juan-felipe-castilla/Digital3/README.md

# Osciloscopio Digital
> **Asignatura:** Electrónica Digital III - Universidad Nacional de Córdoba
> 
> **Integrantes:** 
>  - **Viberti, Benjamín**
>  - **Castilla, Felipe**
>  - **Dalmazzo, Agustín**
>    
> -**Profesor:**
 >- **Blasco Marcos**

---

## 🚀 1. Descripción General del Proyecto
Este proyecto consiste en el diseño y desarrollo de un **Osciloscopio Digital** basado en el microcontrolador **LPC1769** (arquitectura ARM Cortex-M3).

El objetivo principal es la **adquisición de señales analógicas**, su procesamiento  mediante técnicas de software y hardware  y la transmisión a una computadora para su visualización, mediante UART, y tambien posee un generador de funciones interno, para así poder realizar ensayos a diferentes dispositivos.

### 🎯 Alcances del Proyecto 

* **El sistema SÍ es capaz de:**
* 
* Muestrear y procesar señales de frecuencias medias, bajas.
* Una precisión en su medidas válidas para realizar pruebas en casa
* Atenuar señales de entrada, para así ampliar su rango dinamico
* Generar señales de frecuencia fija
* Mostrar tanto niveles de amplitud y tiempo, junto a un botón que muestra la frecuencia de entrada
* 
* **El sistema NO incluye:**
* 
* Muestreo de alta frecuencia
* Una precisión comparable a uno comercial
* Un trigger ajustable

### ⏩ Posibles Etapas Siguientes
Cómo escalar el proyecto:
* Utilizar otro protocolo de comunicación serie, más eficiente
* Utilizar un módulo de adc más exacto, externo
* Agregar una punta compensada
* Poder hacerlo portatil, es decir, que no se requiera una computadora completa para su funcionamiento

---

## 📐 2. Arquitectura del Sistema: Hardware y Software

### 🔌 Hardware & Interconexión
* **Diagrama de Bloques:**Diagrama_Circuito
* **Esquemático del Circuito:** 
  

* **Descripción del Circuito y Consideraciones de Diseño:** En la entrada se encuentra un filtro pasa-bajos de 5kHz que cumple la funcion de filtro anti Aliasing, siguiente a este se puede encontrar un DIP Switch que nos permitira seleccionar entre 2 Atenuadores de -6dB y -20dB o una entrada sin atenuacion. Siguiente a los Atenuadores se encuentra la entrada al ADC y al pin de Capture simultaneamente.
  
* Los botones de interrupcion poseen filtros anti rebote fisicos.
  
* Cada LED cuenta con resistencias limitadoras, se recomienda el uso de Leds rojos.

### 💻 Arquitectura de Software
* **Diagrama de Flujo:** Diagrama_Codigo
---

## ⚡ 3. Especificaciones Eléctricas, Alimentación y Entorno

### 🔌 Parámetros de Alimentación y Consumo
* **Tensión de operación del sistema:** 3.3V
* **Método de alimentación:**  Fuente de alimentación externa
* **Consumo estimado o medido:** * En modo activo, con todos sus modulos operativos 100mA, debido a que el unico componente activo es la lpc
* En modo pasivo(sin el generador de funciones) el consumo baja a los 67mA

### 📌 Entorno:
* **IDE y SDK:** MCUXpresso IDE v11.8 con LPCOpen v2.10
* **Microcontrolador Principal:** NXP LPC1769 
* **Bibliotecas de Terceros y Versiones:** --.
* **Periféricos Avanzados Utilizados:** GPDMA, TIMER, ADC, DAC, UART, GPIO, NVIC ...
* **Estrategia de Concurrencia:** Nuestra estrategia es descargar a la CPU delegando todo el trabajo al hardware (DMA). El main se queda libre esperando comandos de Python por UART, mientras que de fondo los dos canales de DMA hacen todo en paralelo: el Canal 0 (RAM al DAC) envia datos para generar las señales (si está previamente activado el modo), y el Canal 1 (del ADC a la RAM) toma las muestras del generador de funciones. Así, la placa procesa, genera y captura todo al mismo tiempo sin colgarse nunca.

---

## 🔄 4. Proceso de Integración y Desarrollo

* **Etapa 1 (Pruebas UART):** El primer paso fue implementar una UART funcional .
* **Etapa 2 (Plotter):** Desarrollo del plotter en python.
* **Etapa 3 (Adquisición):** Configuración y pruebas de ADC , vía UART.
* **Etapa 4 (Filtrados):** Agreagmos un filtro Anti-Alias(Hardware) y uno de mediana(Software) ..
* **Etapa 5(Generación de señales)** Implementación del DA.
* **Etapa 6(Calibración y Ajuste)** Se ajustaron tiempos de adquisición y comunicación.

---

## 📊 5. Ensayos, Pruebas y Resultados

Se adjunta evidencia del proyecto funcionando, junto con una fotografía del hardware ensamblado:

placa

WhatsApp Image 2026-06-17 at 11 47 51 PM

Prueba funcional: A continuación se presentan imagenes de las siguientes pruebas:

**Prueba 1:** Inyectamos con el generador de funciones una señal cuya forma y frecuencia varía, cambiando lo que se muestra en el osciloscopio digital (acorde a la señal inyectada). Son 3 formas de onda: sinusoidal, cuadrada y triangular.









En la proxima imagen se evidencia como responde al cambio de frecuencia (cambia el ancho de banda de la señal).



**Prueba 2:** DAC y el generador de señales para calibrar el osciloscopio. Se activa DAC con EINT0 y encendemos un LED indicador (LED VERDE).



A medida que se presiona EINT1, se encienden determinados LEDS ROJOS a modo de indicador de que señal se está generando.



Por último, imagenes de las señales generadas (triangular, sinusoidal y cuadrada).







**Prueba 3:** Captura de la freuencia de la señal inyectada por el generador mediante CAPTURE. Se muestra la frecuencia en pantalla tras la pulsación de EINT2.

880Hz de señal inyectada.



Mensaje en pantalla.



---

## 📂 6. Estructura del Repositorio
```text
├── Osciloscopio-Digital/           # Carpeta principal del proyecto del osciloscopio
│   ├── codigo/                     # Código fuente del firmware
│   │   ├── CMSISv2p00_LPC17xx/     # Librerías base del sistema y soporte CMSIS para LPC17xx
│   │   └── Osc_Project/                # Proyecto principal de desarrollo en el IDE
│   │       └── src/                # Archivos fuente del firmware
│   │           ├── codigos/        # Implementación de drivers y control de periféricos (.c)
│   │           ├── extras/         # Archivos de arranque y configuración del sistema
│   │           └── headers/        # Archivos de cabecera y definiciones (.h)
│   └── python-screen/              # Interfaz gráfica de usuario (GUI) desarrollada en Python
├── extras/                         # Trabajos hechos a lo largo de la cursada
├── Diagrama_Code.pdf               # Diagrama de flujo / bloques del firmware
├── Diagrama_Hardware.pdf           # Diagrama de bloques del diseño electrónico
├── Esquematico Osc. ED3.pdf        # Plano esquemático del circuito en formato PDF
├── Osciloscopio ED3.kicad_sch      # Archivo de esquema electrónico ejecutable en KiCad
└── README.md                       # Archivo de presentación del repositorio
