juan-felipe-castilla/Digital3/Diagrama_Hardware.pdf

# al UART Salida

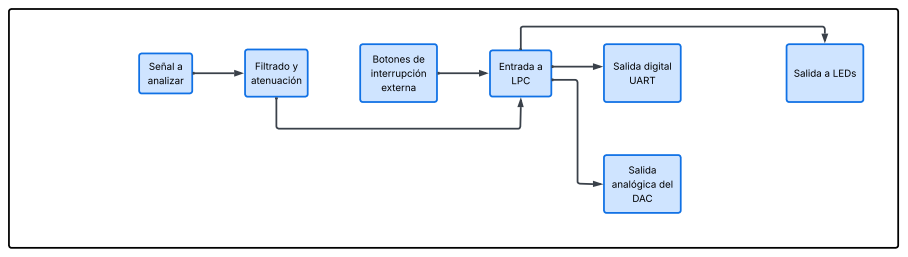
[picture p1: page 1]
aliz; Filt; ció; alid; digit; aló; gic; el DAC; e interrupción externa
