juan-felipe-castilla/Digital3/Diagrama_Code.pdf

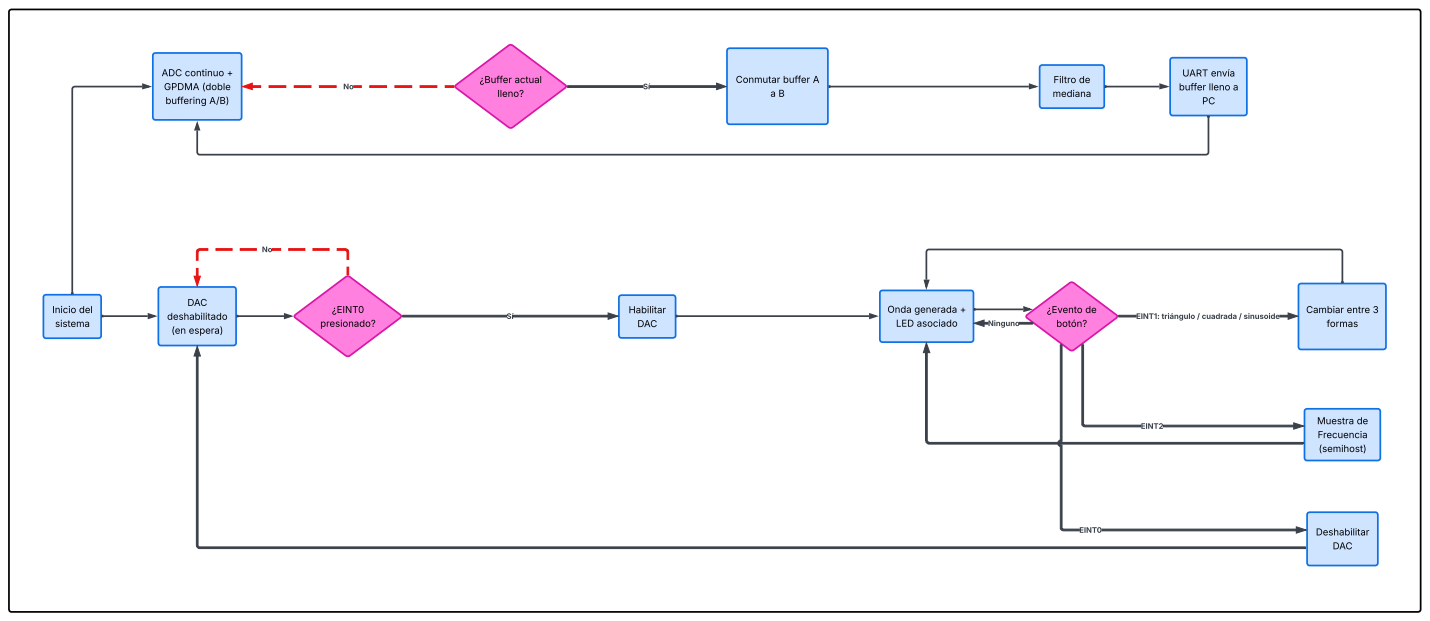
[picture p2: page 1]
Inicio del sistema; ADC continuo + GPDMA (doble buffering A/B); ¿Buffer actual lleno?; Conmutar buffer A a B; UART envía buffer lleno a PC; DAC deshabilitado (en espera); ¿EINT0 presionado?; Habilitar DAC; Onda generada + LED asociado; ¿Evento de botón?; Cambiar entre 3 formas; Muestra de Frecuencia (semihost); Deshabilitar DAC; EINT1: triángulo / cuadrada / sinusoide; EINT2; EINT0; Ninguno; Filtro de mediana
