juan-felipe-castilla/Digital3/Esquematico Osc. ED3.pdf

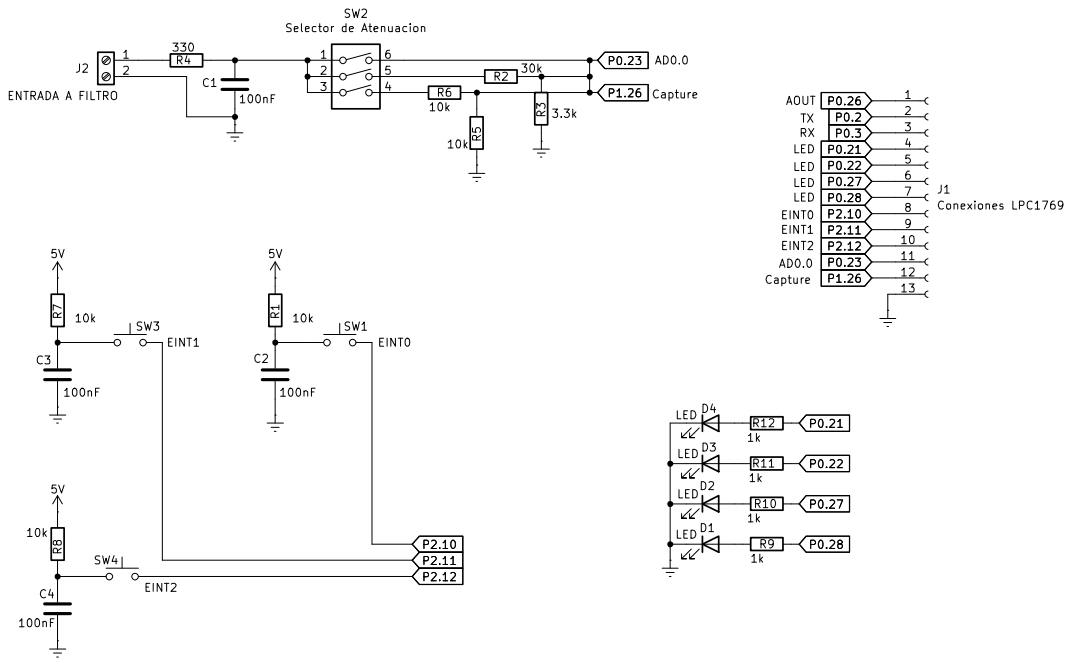
[picture p3: page 1]
