juan-felipe-castilla/Digital3/Osciloscopio ED3.kicad_sch

## KiCad design Osciloscopio ED3.kicad_sch (2026-06-13)

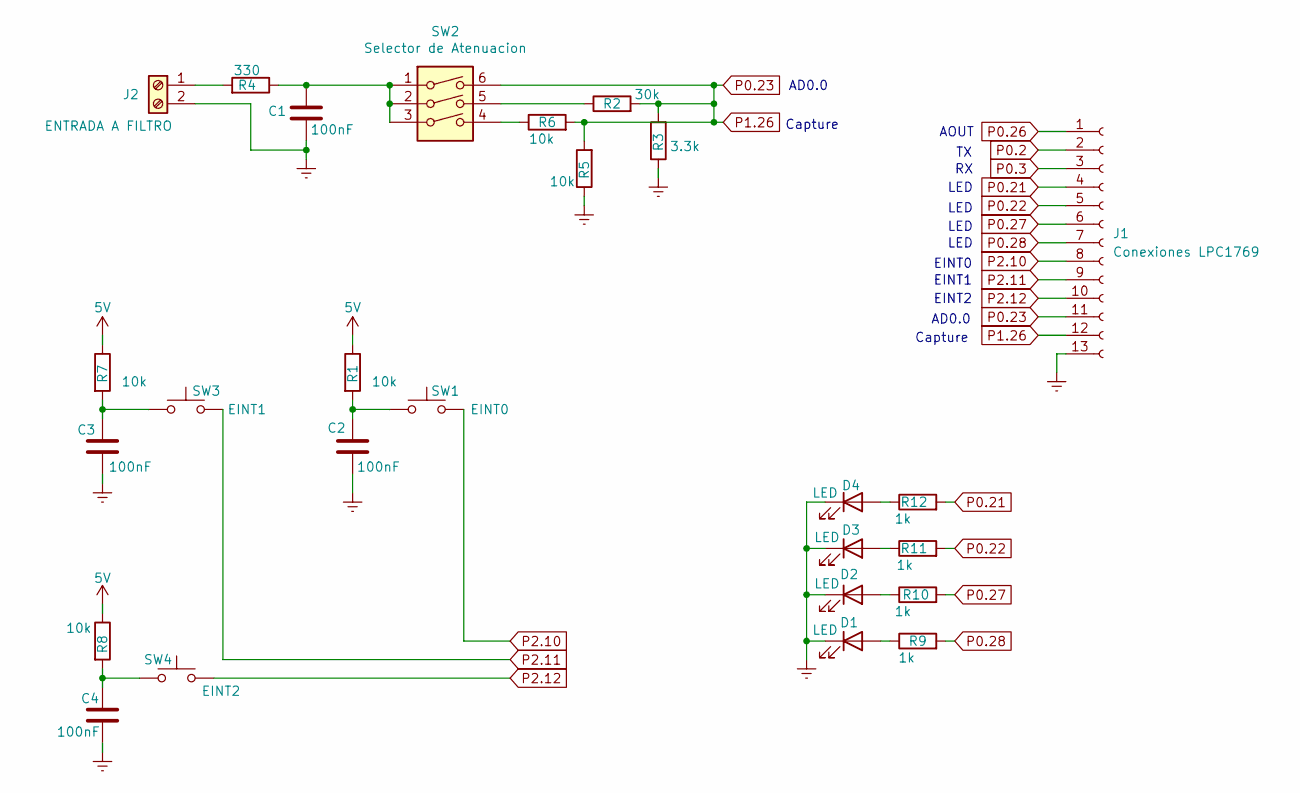
[picture p4: schematic Osciloscopio ED3.kicad_sch]

Parts:
C1, C2, C3, C4: 100nF
D1, D2, D3, D4: LED
J1: Conexiones LPC1769
J2: ENTRADA A FILTRO
R1, R5, R6, R7, R8: 10k
R2: 30k
R3: 3.3k
R4: 330
R9, R10, R11, R12: 1k
SW1: EINT0
SW2: Selector de Atenuacion
SW3: EINT1
SW4: EINT2

Connections:
5V: R1.1, R7.1, R8.1
Earth: C1.2, C2.2, C3.2, C4.2, D1.1 (K), D2.1 (K), D3.1 (K), D4.1 (K), J1.13, J2.2, R3.1, R5.1
unnamed: C1.1, R4.1, SW2.1, SW2.2, SW2.3
unnamed: C2.1, R1.2, SW1.1
unnamed: C3.1, R7.2, SW3.1
unnamed: C4.1, R8.2, SW4.1
unnamed: D1.2 (A), R9.1
unnamed: D2.2 (A), R10.1
unnamed: D3.2 (A), R11.1
unnamed: D4.2 (A), R12.1
unnamed: J2.1, R4.2
unnamed: R2.1, SW2.5
unnamed: R6.1, SW2.4
P0.2: J1.2
P0.3: J1.3
P0.21: J1.4, R12.2
P0.22: J1.5, R11.2
P0.23: J1.11, J1.12, R2.2, R3.2, R5.2, R6.2, SW2.6
P0.26: J1.1
P0.27: J1.6, R10.2
P0.28: J1.7, R9.2
P2.10: J1.8, SW1.2
P2.11: J1.9, SW3.2
P2.12: J1.10, SW4.2

Notes on the sheet:
Capture
EINT0
AOUT
LED
EINT1
AD0.0
EINT2
