juan-felipe-castilla/Digital3/Osciloscopio-Digital/codigo/Osc_Project/src/headers/o-dac.h

/*
 * o-dac.h
 *
 *  Created on: 25 may. 2026
 *      Author: benja
 */

#ifndef O_DAC_H_
#define O_DAC_H_

void conf_DAC();
void generate_triangle_in_memory(void);
void generate_square_in_memory(void);
void generate_sine_in_memory(void);
void conf_LED(void);

#endif /* O_DAC_H_ */
