juan-felipe-castilla/Digital3/Osciloscopio-Digital/codigo/Osc_Project/src/headers/o-exti.h

/*
 * o-exti.h
 *
 *  Created on: 28 may. 2026
 *      Author: 54346
 */

#ifndef HEADERS_O_EXTI_H_
#define HEADERS_O_EXTI_H_



#endif /* HEADERS_O_EXTI_H_ */

void conf_EXTI();
void EINT0_IRQHandler(void);
void EINT1_IRQHandler(void);
void EINT2_IRQHandler(void);
