juan-felipe-castilla/Digital3/Osciloscopio-Digital/codigo/Osc_Project/src/headers/o-tim2CAP.h

/*
 * tim0CAP.h
 *
 *  Created on: 1 jun. 2026
 *      Author: Usuario
 */

#ifndef HEADERS_O_TIM2CAP_H_
#define HEADERS_O_TIM2CAP_H_


void confTIM2(void);
void confCAP(void);
void TIMER0_IRQHandler(void);




#endif /* HEADERS_O_TIM2CAP_H_ */
