juan-felipe-castilla/Digital3/(commit log)

2026-03-22 programa a probar, toggle led con interrupcion externa
2026-03-26 Agregado de systick
2026-03-26 Codigo de interrupcion por GPIO funcional
2026-04-02 Agregamos el handler de la interrupcion externa que llama a sensor
2026-04-02 Primer Ejercicio de ADC del aula virtual
2026-04-02 agragado ej adc
2026-04-03 ejercicio adc 2
2026-04-04 ultimo ej de ADC
2026-04-04 mi manera de hacer el ejercicio1 del parcial 2023
2026-04-06 Correccion de codigo
    ajuste un toque el formato,comente una linea que puede faltar limite le valor de logica_secuencia
2026-04-11 uhh no se q es esto, creo q es porq le cambie el nombre
2026-04-23 codigo osciloscopio a pelo
    Deje comenarios en varios archivos para tener en cuenta la optimizacion, entender cuentas de frecuencia y futuras implementaciones de mejora
2026-05-08 DAC con Drivers, sin DMA
2026-05-11 agrego tp DAC con DMA en carpeta nueva
2026-05-12 codigo con dma y dac funcional
2026-05-15 el ejercicio que hicimos con trujillo
2026-05-17 parciales resueltos, termine el de trujillo
    soy un puto genio
2026-05-19 tp de mediciones quiero keke
2026-05-20 Revert "Organizar archivos en carpeta osciloscopio"
    [uart.c]
2026-05-21 acomode, en tp mediciones esta el funcional
2026-05-28 arreglando cosas pt4 lindo keke
    [o-adc.c, o-adc.h, o-dac.c, o-dac.h, o-dma.c]
2026-05-28 agregado de eint y dac. no anda
2026-06-02 DAC completamente funcional. Falta arreglar capture
    [o-dac.c, o-dac.h, o-dma.c, o-exti.c, o-exti.h, o-main.c, o-tim2CAP.c, o-tim2CAP.h]
2026-06-04 fix: capture arreglado. falta testear
    [o-exti.c, o-main.c, o-tim2CAP.c]
2026-06-13 Forma final
    inicio de modelado de readme final
2026-06-13 Toqueteando el readme
2026-06-13 cambios readme
    Updated hardware section with images and detailed circuit description.
2026-06-13 intento de q profesor quede bien
2026-06-18 Formato profesional
    Cambio de nombres en archivos y eliminación de archivos basura
